ko6lvm/black-bear/img/blender/open.png

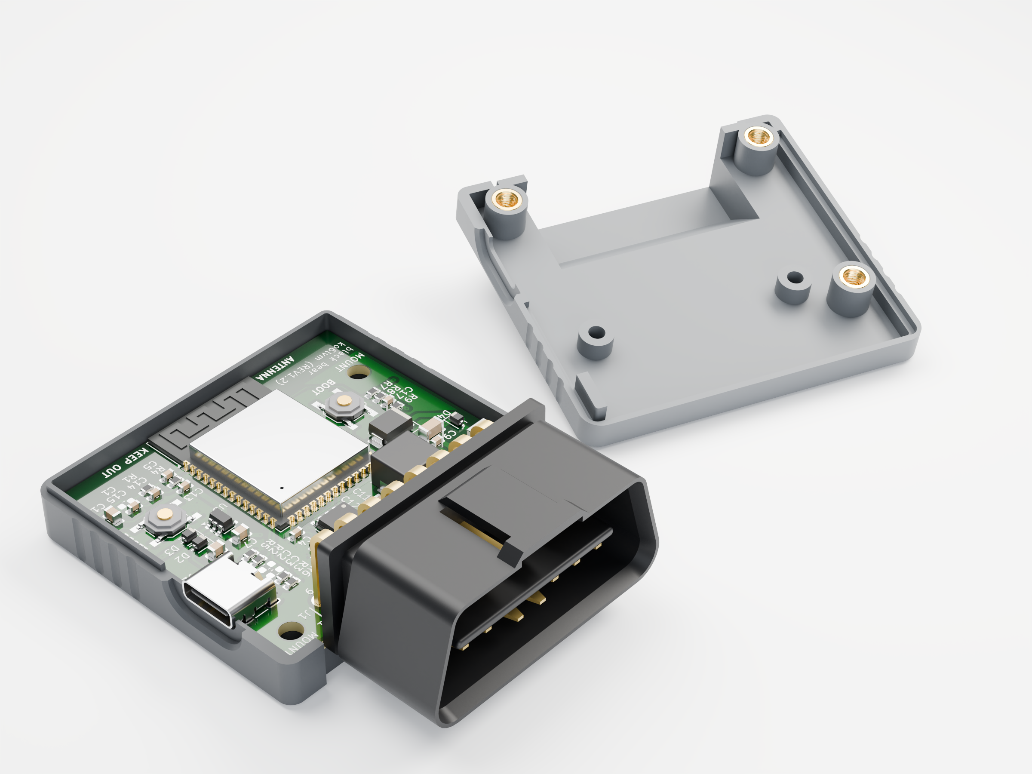
img/blender/open.png
