ko6lvm/black-bear/img/blender/bottom.png

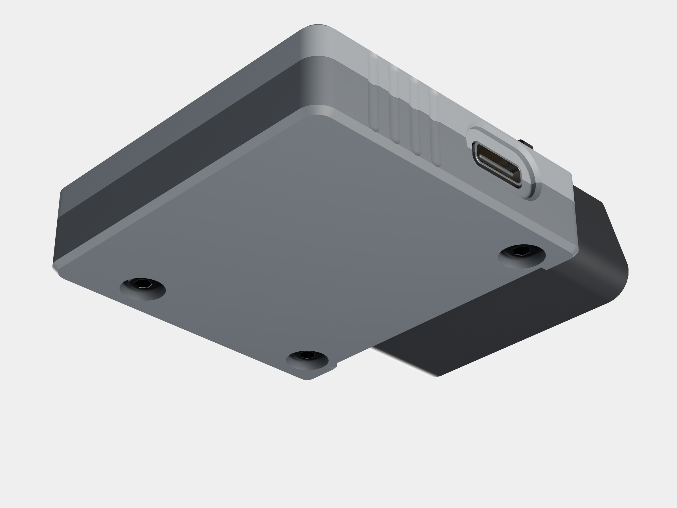
img/blender/bottom.png
