ko6lvm/black-bear/img/blender/exploded.png

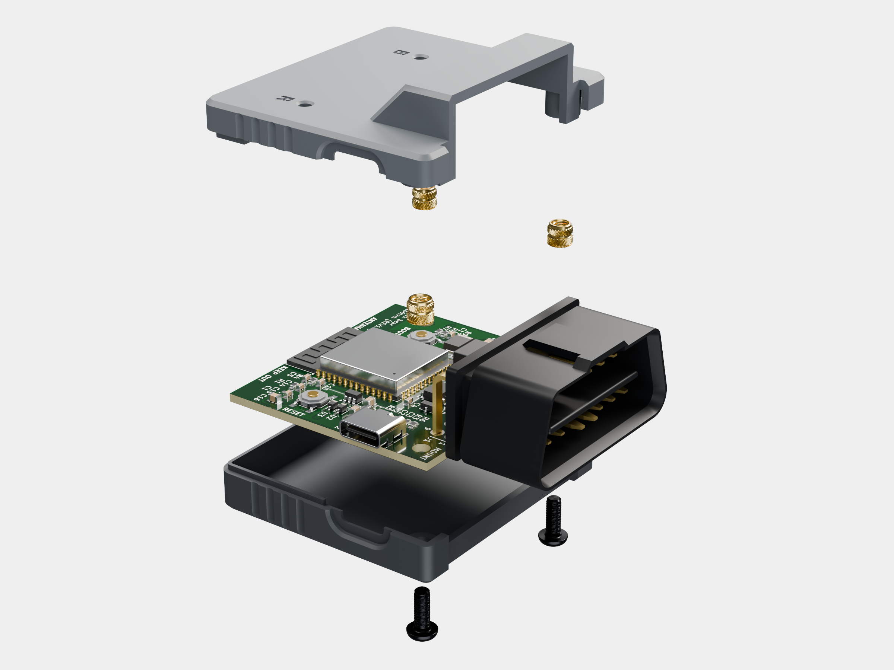
img/blender/exploded.png
