ko6lvm/black-bear/img/blender/front.png

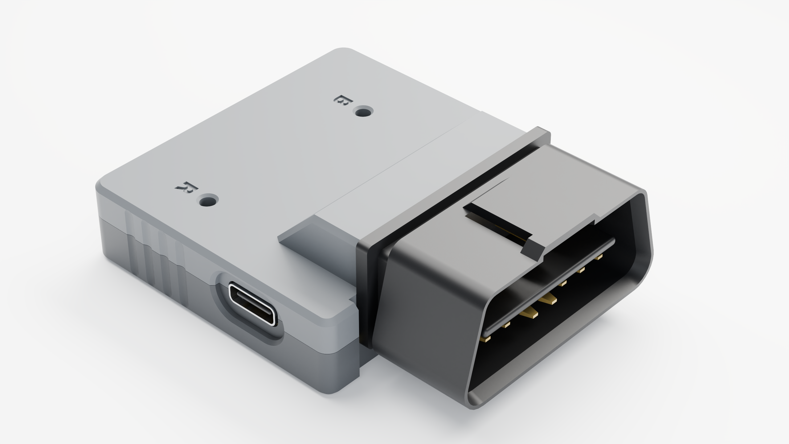
img/blender/front.png
