ko6lvm/black-bear/img/bottom.png

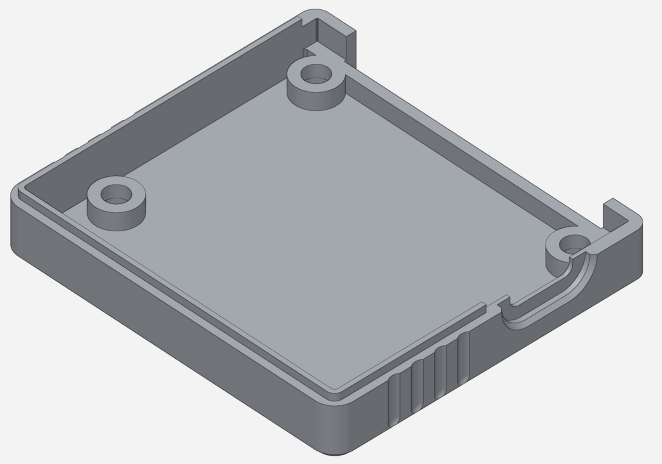
img/bottom.png
