ko6lvm/black-bear/img/pcb-editor.png

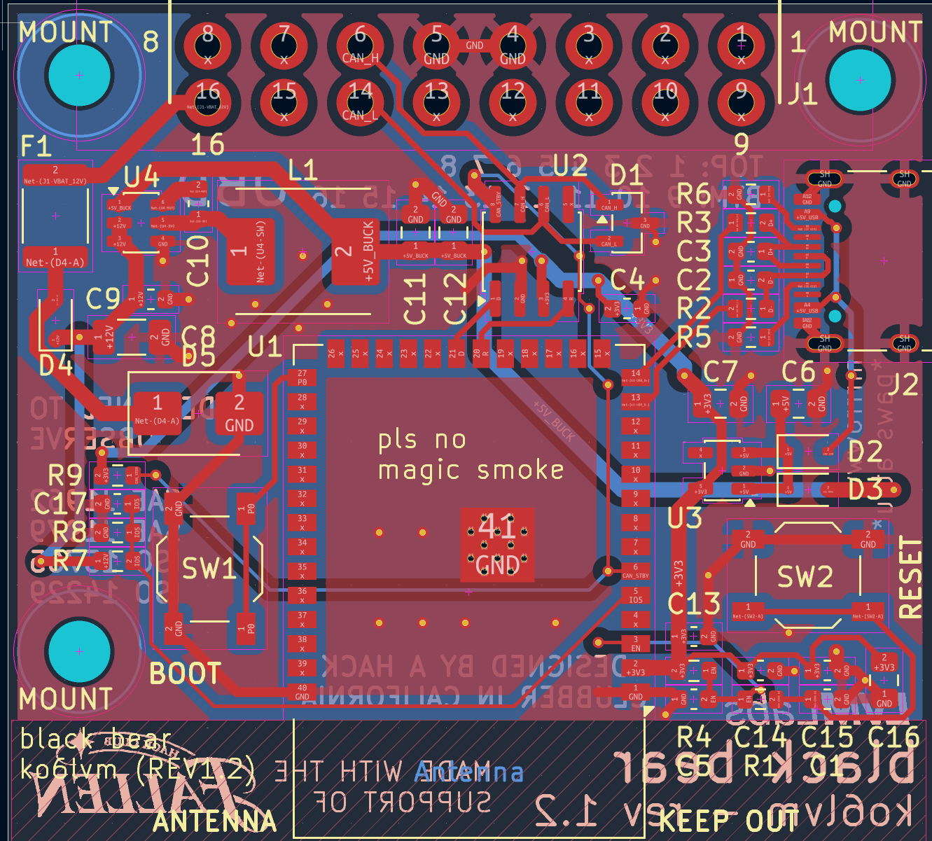
img/pcb-editor.png
