ko6lvm/black-bear/img/pcb.png

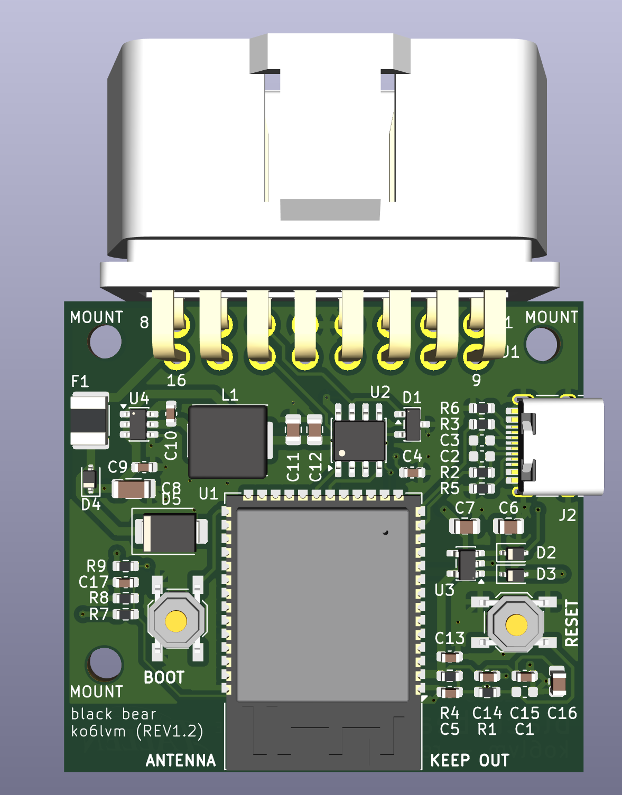
img/pcb.png
