ko6lvm/black-bear/img/schematic.png

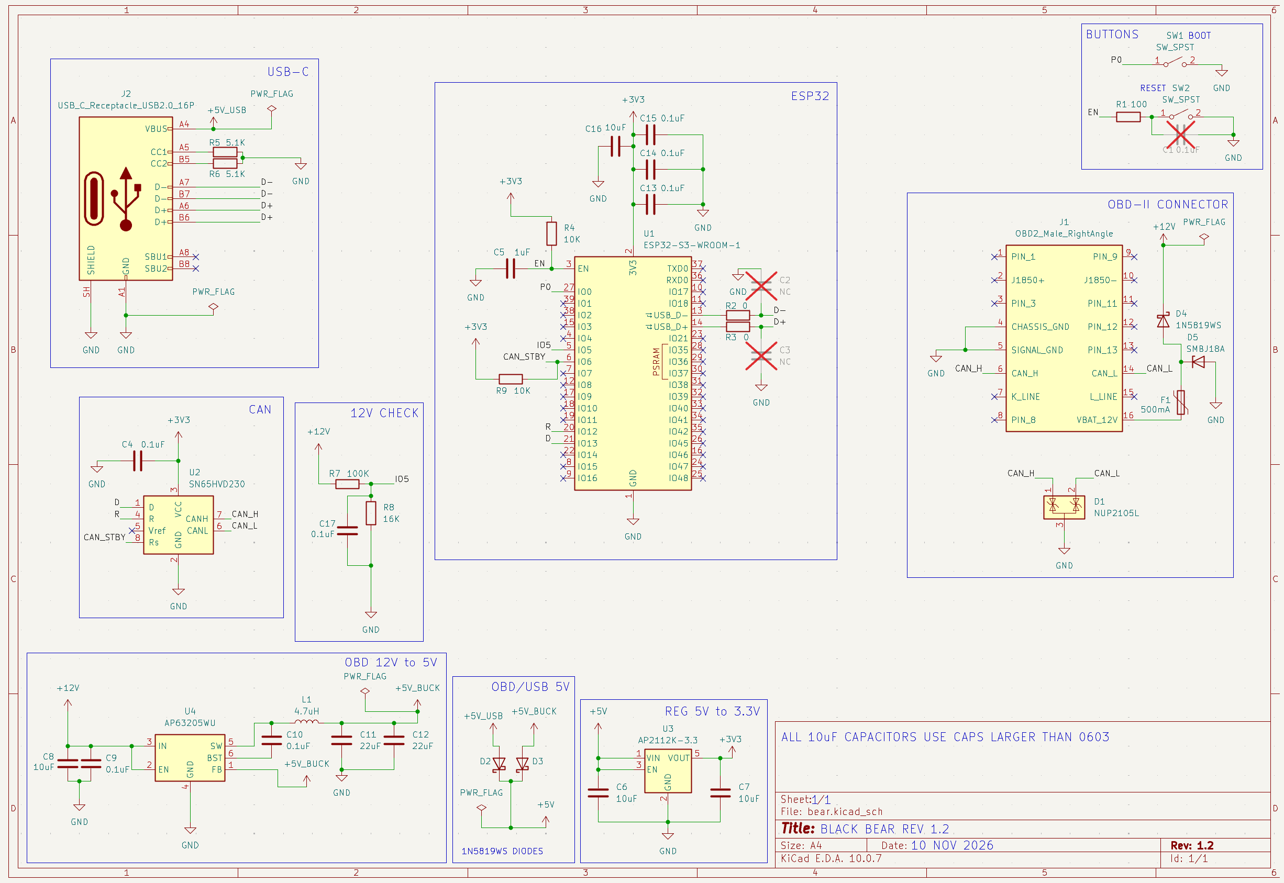
img/schematic.png
