ko6lvm/black-bear/img/top-heatset.png

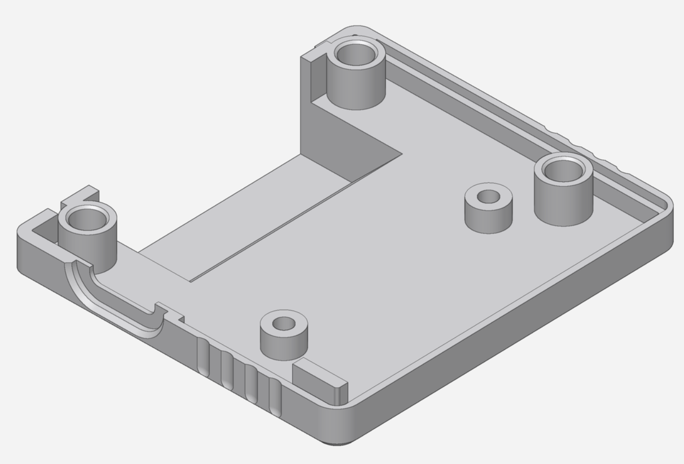
img/top-heatset.png
