ko6lvm/black-bear/cad/case-bottom/case-bottom.step

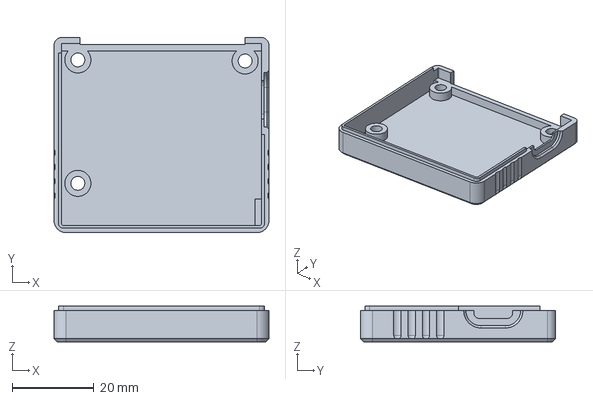
[picture p11: CAD file, 2026-11-11]
cad/case-bottom/case-bottom.step
52.7 x 47.9 x 8.75 mm
