ko6lvm/black-bear/cad/case-top-heatset/case-top-heatset.step

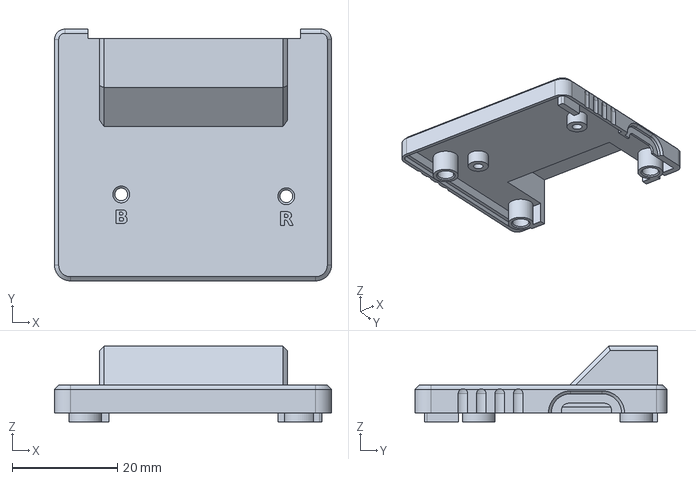
[picture p12: CAD file, 2026-11-11]
cad/case-top-heatset/case-top-heatset.step
52.7 x 47.9 x 14.4 mm
