ko6lvm/black-bear/(list of files, cad)

Other CAD files:
cad/case-top-selftap/case-top-selftap.step
cad/case-bottom/case-bottom.stl
cad/case-top-heatset/case-top-heatset.stl
cad/case-top-selftap/case-top-selftap.stl
