ko6lvm/black-bear/pcb/bear.kicad_pcb

## KiCad design pcb/bear.kicad_pcb (2026-11-13)

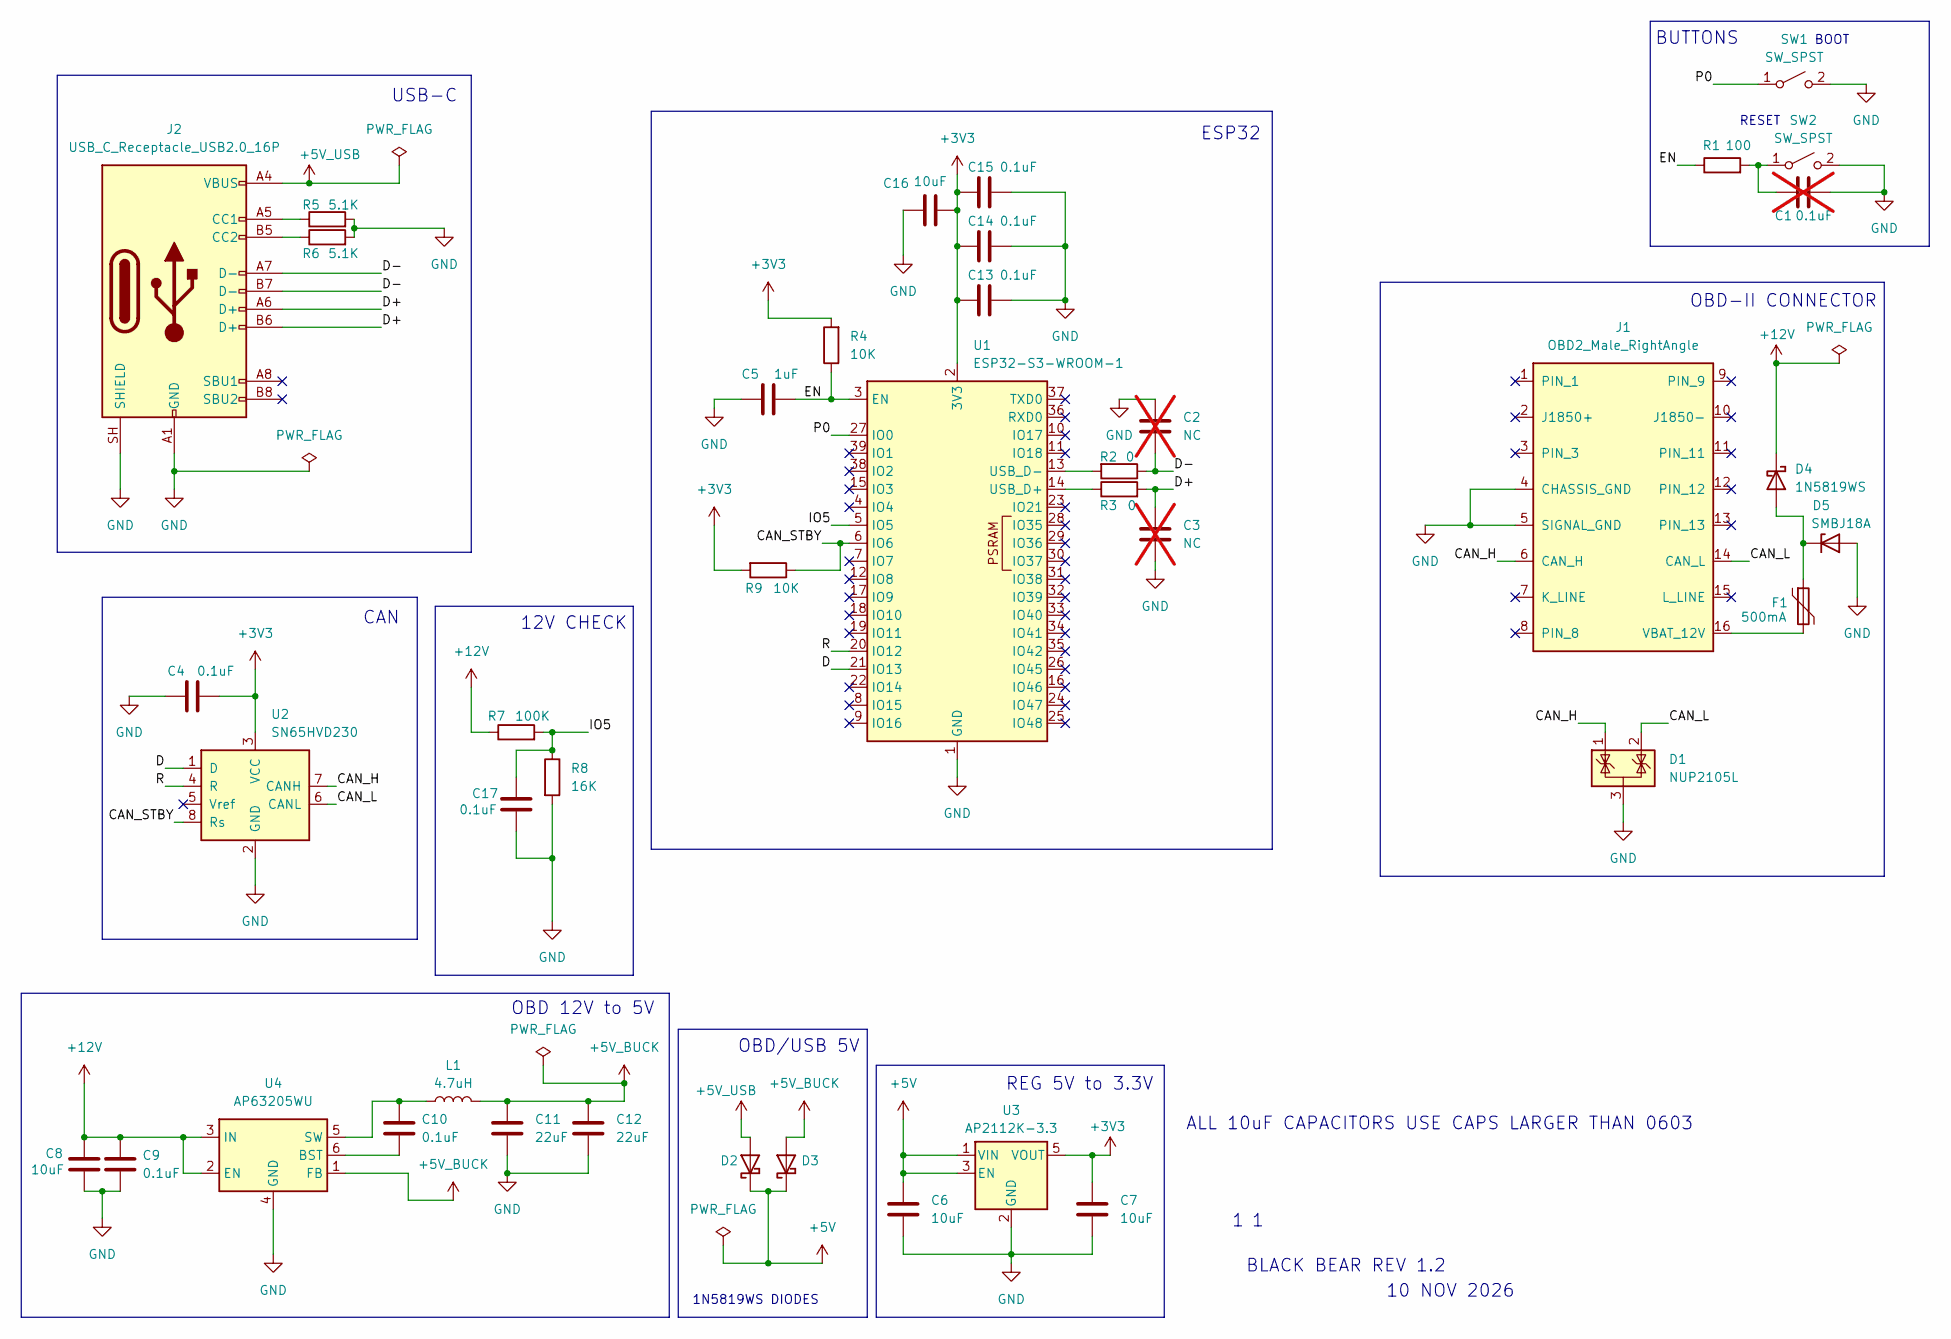
[picture p13: schematic bear.kicad_sch]

Parts:
C1: 0.1uF; C_0603_1608Metric; not fitted
C2, C3: NC; C_0603_1608Metric; not fitted
C4, C9, C10, C13, C14, C15, C17: 0.1uF; C_0603_1608Metric
C5: 1uF; C_0603_1608Metric
C6, C7, C16: 10uF; C_0805_2012Metric
C8: 10uF; C_1206_3216Metric
C11, C12: 22uF; C_0805_2012Metric
D1: NUP2105L; SOT-23
D2, D3, D4: 1N5819WS; D_SOD-323
D5: SMBJ18A; D_SMB
F1: 500mA; Fuse_1812_4532Metric
J1: OBD2_Male_RightAngle
J2: USB_C_Receptacle_USB2.0_16P; USB_C_Receptacle_HRO_TYPE-C-31-M-12
L1: 4.7uH; L_CKST0605
R1: 100; R_0603_1608Metric
R2, R3: 0; R_0603_1608Metric
R4, R9: 10K; R_0603_1608Metric
R5, R6: 5.1K; R_0603_1608Metric
R7: 100K; R_0603_1608Metric
R8: 16K; R_0603_1608Metric
SW1, SW2: SW_SPST; SW_SPST_TL3342
U1: ESP32-S3-WROOM-1
U2: SN65HVD230; SOIC-8_3.9x4.9mm_P1.27mm
U3: AP2112K-3.3; SOT-23-5
U4: AP63205WU; TSOT-23-6

Connections:
+3V3: C4.2, C7.1, C13.1, C14.1, C15.1, C16.2, R4.2, R9.2, U1.2 (3V3), U2.3 (VCC), U3.5 (VOUT)
+5V: C6.1, D2.1 (K), D3.1 (K), U3.1 (VIN), U3.3 (EN)
+5V_BUCK: C11.1, C12.1, D3.2 (A), L1.2, U4.1 (FB)
+5V_USB: D2.2 (A), J2.A4 (VBUS), J2.A9 (VBUS), J2.B4 (VBUS), J2.B9 (VBUS)
+12V: C8.1, C9.1, D4.1 (K), R7.1, U4.2 (EN), U4.3 (IN)
/CAN_H: D1.1 (K), J1.6 (CAN_H), U2.7 (CANH)
/CAN_L: D1.2 (K), J1.14 (CAN_L), U2.6 (CANL)
/CAN_STBY: R9.1, U1.6 (IO6), U2.8 (Rs)
/D: U1.21 (IO13), U2.1 (D)
/D+: C3.1, J2.A6 (D+), J2.B6 (D+), R3.2
/D-: C2.2, J2.A7 (D-), J2.B7 (D-), R2.1
/EN: C5.2, R1.1, R4.1, U1.3 (EN)
/IO5: C17.1, R7.2, R8.1, U1.5 (IO5)
/P0: SW1.1 (A), U1.27 (IO0)
/R: U1.20 (IO12), U2.4 (R)
GND: C1.2, C2.1, C3.2, C4.1, C5.1, C6.2, C7.2, C8.2, C9.2, C11.2, C12.2, C13.2, C14.2, C15.2, C16.1, C17.2, D1.3 (A), D5.2 (A), J1.4 (CHASSIS_GND), J1.5 (SIGNAL_GND), J2.A1 (GND), J2.A12 (GND), J2.B1 (GND), J2.B12 (GND), J2.SH (SHIELD), R5.2, R6.2, R8.2, SW1.2 (B), SW2.2 (B), U1.1 (GND), U1.40 (GND), U1.41 (GND), U2.2 (GND), U3.2 (GND), U4.4 (GND)
unnamed: D4.2 (A), D5.1 (K), F1.1
unnamed: F1.2, J1.16 (VBAT_12V)
unnamed: J2.A5 (CC1), R5.1
unnamed: J2.B5 (CC2), R6.1
unnamed: C1.1, R1.2, SW2.1 (A)
unnamed: R3.1, U1.14 (USB_D+)
unnamed: R2.2, U1.13 (USB_D-)
unnamed: C10.2, U4.6 (BST)
unnamed: C10.1, L1.1, U4.5 (SW)

Notes on the sheet:
USB-C
ESP32
CAN
10 NOV 2026
ALL 10uF CAPACITORS USE CAPS LARGER THAN 0603
REG 5V to 3.3V
OBD 12V to 5V
OBD/USB 5V
OBD-II CONNECTOR
12V CHECK
BOOT
RESET
BLACK BEAR REV 1.2
BUTTONS
1N5819WS DIODES

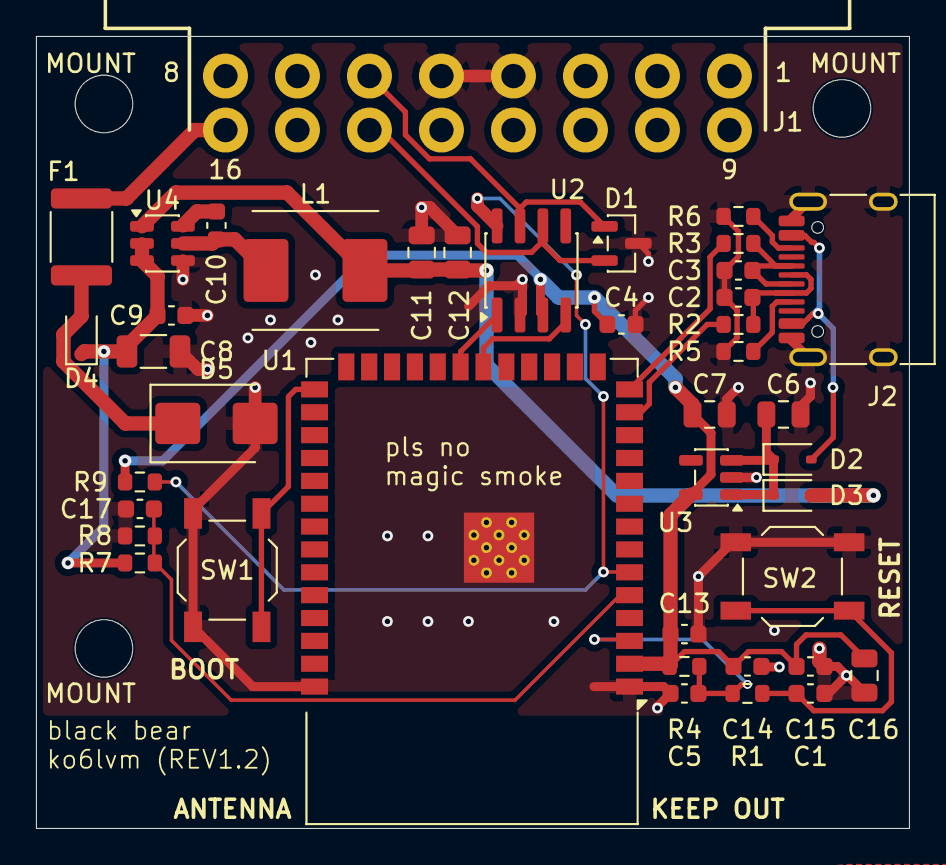
[picture p14: board bear.kicad_pcb from above]

Board: 2 copper layers, 48.5 x 44.0 mm, 44 parts (0 on the bottom side), 25 nets.

Other parts of the board:
MOUNT: MountingHole_3.2mm_M3
MOUNT#2, MOUNT#3: MountingHole_3.2mm_M3
