ko6lvm/black-bear/(commit log)

2026-11-11 images and cad, no pcb/bom yet
    [case-bottom.step, case-bottom.stl, case-top-heatset.step, case-top-heatset.stl, case-top-selftap.step, case-top-selftap.stl]
2026-11-12 BoMs, renders, kicad files, and fw!
    [BOM_jlcpcb_eco.csv, BOM_jlcpcb_standard.csv, bear.kicad_pcb, bear.kicad_sch, bom.csv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]
2026-11-12 fix bom
    [bom.csv]
2026-11-13 REV1.2: voltage sensor, bom fixes
    [BOM_jlcpcb_eco.csv, BOM_jlcpcb_standard.csv, bear.kicad_pcb, bear.kicad_sch, bom.csv, submit_bom.csv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]
