ko6lvm/black-bear/img/blender/macro.png

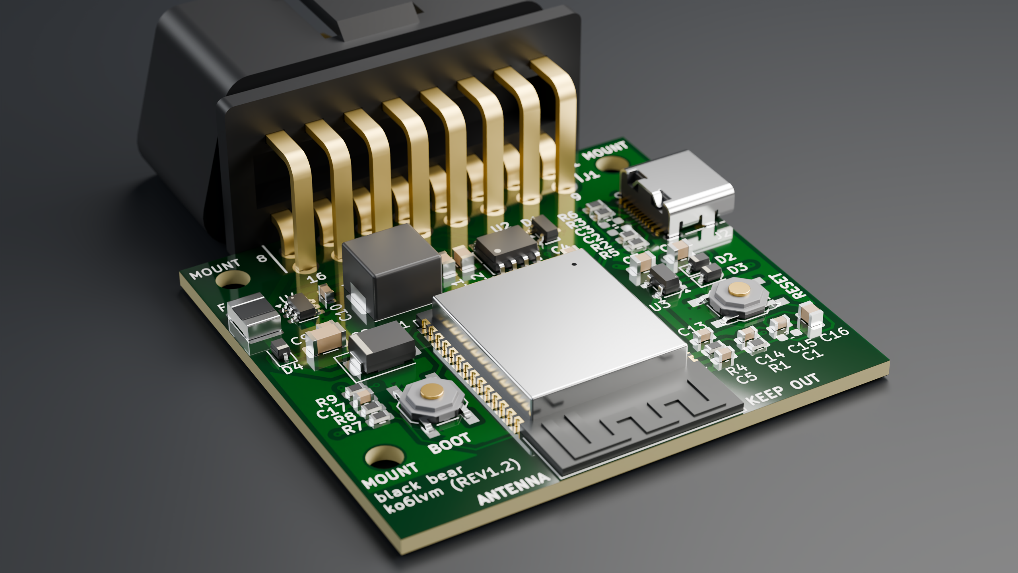
img/blender/macro.png
